cdh66666/mini-drone/docs/hardware/硬件说明.md

# 硬件资料说明（原理图 / PCB / KiCad 工程）

板号：**ESP32-1S-Basic-R4-E07**　　整理日期：2026-11-09

这个目录放的是**电路侧**的资料，和上级目录的固件、调试页配套。
看引脚接线直接看第二节的对照表，不用去翻 PDF。

---

## 一、三个文件分别是什么

| 文件 | 内容 | 大小 | 怎么用 |
| --- | --- | --- | --- |
| `01_原理图_SCH_ESP32-1S-Basic-R4-E07_2026-11-08.pdf` | 完整原理图，1 页全展开 | 219 KB | 看网络连接、查器件位号、对照飞线 |
| `02_PCB图_PCB_ESP32-1S-Basic-R4-E07_2026-11-08.pdf` | PCB 各层视图，6 页 | 1.66 MB | 看叠层/走线/丝印/焊盘位置 |
| `03_KiCad工程与制造文件_20261109.zip` | KiCad 工程 + Gerber + 钻孔 + BOM + 贴装坐标 + DRC/ERC 报告，177 个文件 | 12.2 MB | 要改板才解压，见下面「怎么打开」 |

### 怎么打开 KiCad 工程

1. 整个 zip **完整解压**（不要只挑 `.kicad_pcb` 出来，它会找不到符号/封装/3D 模型）；
2. 打开 `01_历史工程_v5_非实板确认版/KiCad/ESP32-1S-Basic-R4-E07-Layout.kicad_pro`；
3. 需要 **KiCad 10.0.7 或更新的版本**（用 9.x 打开会提示工程版本过新）。

包里同时附了原整理方写的 `00_先读_版本与缺失.txt`、`README-先读-审阅范围.txt` 和
`SHA256SUMS.txt`，**建议先看那两个 txt**。

### ⚠️ 版本警告（重要）

包里的可编辑工程是 **2026-10-31 的 E08 v5 历史审阅版**，**不是**你手上这块板的最终版：

- 之后在嘉立创 EDA 里还做过板框圆角、原理图警告整理、MEC 关联修正，这些**没有**包含在里面；
- 里面的 Gerber 是**历史审阅文件，不要拿它再下一次单**；
- 贴装坐标只对那个历史版本有效，**不要直接套到实板**。

**判断依据永远是：实际制板订单的文件 + 实板丝印 + 实测。**
本目录的 PDF 是 11-08 从嘉立创导出的当前版视图，看接线以 PDF 为准，改板以云端工程为准。

---

## 二、引脚对照表（原理图网标 ↔ 固件）

从 `02_接口焊盘网络_历史v5.csv` 和 WROOM-1 符号表交叉核对出来的，
**和 `01_firmware/flight_v1` 里的引脚定义逐条一致**（这是本次核对的重点）。

| 功能 | 原理图网标 | U1 焊盘 | ESP32 GPIO | 固件里的名字 |
| --- | --- | --- | --- | --- |
| 电机 M1（前左） | `PWM1` → `M1_GATE` | 4（IO4） | **4** | `PIN_M1` |
| 电机 M2（前右） | `PWM2` → `M2_GATE` | 5（IO5） | **5** | `PIN_M2` |
| 电机 M3（后左） | `PWM3` → `M3_GATE` | 6（IO6） | **6** | `PIN_M3` |
| 电机 M4（后右） | `PWM4` → `M4_GATE` | 7（IO7） | **7** | `PIN_M4` |
| IMU SDA | `IMU_SDA` | 18（IO10） | **10** | `PIN_SDA` |
| IMU SCL | `IMU_SCL` | 19（IO11） | **11** | `PIN_SCL` |
| IMU 中断 | `IMU_INT` | 20（IO12） | 12 | **未使用**（轮询读取） |
| 电池电压采样 | `VBAT_ADC` | 38（IO2） | **2** | `PIN_VBAT` |
| USB 插入检测 | `USB_PGOOD_N` | 17（IO9） | **9** | `PIN_PGOOD`（低有效） |
| 原生 USB D− / D+ | `USB_DM_MCU` / `USB_DP_MCU` | 13 / 14（IO19/IO20） | — | 硬件 USB CDC，不用配 |
| 串口 0 | `UART_RX` / `UART_TX` | 36 / 37（IO44/IO43） | — | 引到 TP3/TP4，固件不用 |
| 复位 / 下载 | `EN` / `BOOT` | 3 / 27（IO0） | — | 引到 TP1/TP2 |

### 测试点（USB 焊盘坏了也能救）

| 测试点 | 网络 | 用途 |
| --- | --- | --- |
| TP1 | `EN` | 拉低 = 复位 |
| TP2 | `BOOT` | 上电时拉低 = 进下载模式 |
| TP3 | `UART_TX` | 备用串口（接 USB-TTL） |
| TP4 | `UART_RX` | 备用串口 |
| TP5 | `3V3` | 量 3.3 V |
| TP6 | `GND` | 地 |

> 板子方位：**USB 口那一侧是机尾**，M1/M2 在机头。M1 ↔ M4 对角、M2 ↔ M3 对角。

---

## 三、关键器件（BOM 核对过）

| 位号 | 型号 | 作用 | 备注 |
| --- | --- | --- | --- |
| U1 | **ESP32-S3-WROOM-1-N8R2** | 主控 | 8 MB Flash + 2 MB PSRAM，实测吻合 |
| U2 | **TPS63020DSJR** | 升降压 DC-DC → 3V3 | 1S 电池 3.0–4.2 V 全程稳 3.3 V |
| U3 | **QMI8658A** | 六轴 IMU | I2C `0x6B`，LGA-14 |
| U4 | **BQ24073RGTR** | 线性充电管理 | USB 插入充电 + 系统供电，实测 189 mA |
| Q1–Q4 | **CJ3400**（SOT-23 NMOS） | 四路电机低边开关 | 栅极 330R 串阻 + 100k 下拉 |
| D1–D4 | **SS34**（SMA 肖特基） | 电机续流 | 关断时给电机电流留回路 |
| L1 | 1.5 µH（MWSA0518S-1R5MT） | TPS63020 电感 | |
| J1 | KH-TYPE-C-16P | USB-C 口 | 16 pin，含 CC 电阻 5.1k |
| J2 | 电池焊盘 | 1S 电池输入 | |
| JM1–JM4 | 电机焊盘 | 四路电机输出 | 每路 2 pin：VBAT + 漏极 |

**驱动器拓扑（决定了固件的限制）**：

```
VBAT ── 电机 ── JMx ── Qx(CJ3400, 低边 NMOS) ── GND
```

低边斩波、**只能单向导通**：固件没法反转转向，换向只能对调电机两根线
（详见上级 `README.md` 第 3.4 节）。四轴本来就只需要一个方向，靠正反桨抵消反扭。

---

## 四、和固件/文档的对应关系

| 想查什么 | 看哪里 |
| --- | --- |
| 引脚 → 固件变量 | 本文件第二节 |
| 实测电压/充电电流/IMU/射频 | `../04_docs/测试报告_2026-11-08.md` |
| 编译参数（FQBN 四项） | `../README.md` 第四节 |
| 烧录地址 | `../03_bin/flash_args.txt` 和 `烧录说明.txt` |
| 板子丝印与焊盘位置 | `02_PCB图_...pdf` |
| 改板 / 重新下单 | `03_KiCad工程与制造文件_20261109.zip` —— **但那不是最终版，务必从嘉立创云端工程重新导出** |

---

## 五、文件校验（SHA256）

用于确认传输过程没损坏，不是安全验证：

```
b21479bebe028deceafcf9701811e0e159e546ab097fe9e5d8eeb88f3b7027f9  01_原理图_SCH_ESP32-1S-Basic-R4-E07_2026-11-08.pdf
92ef4f147be5dbc3df9b1bb112a23c6b671f24f32eea6c8d500278ec2a9ee25d  02_PCB图_PCB_ESP32-1S-Basic-R4-E07_2026-11-08.pdf
06b610a558527d2b6ef2a2d76e942dcb7ad5a38f47f2bf19ceb2d27232eb7394  03_KiCad工程与制造文件_20261109.zip
```

Windows 上核对：

```powershell
Get-FileHash 01_*.pdf -Algorithm SHA256
```

---

## 六、这份硬件资料不包含什么

- ❌ 不含已验证适配实板的**电机固定架**（3D 打印件）——保持力、振动、打印公差都没验过；
- ❌ 不含最终版嘉立创云端工程（`.epro2`）的原生导出；
- ❌ 不含任何电气/热/振动的第三方复检报告；
- ❌ 不含 PCB 叠层铜厚与阻抗的实测数据。

这些缺口不影响按本包调参飞行，但**别拿它当"可以做认证/量产"的依据**。
