cdh66666/mini-drone/交接.md

# mini 无人机

- 项目对话由“总控”开，标题“mini无人机”。和“三门项目课”里的陆空两栖清洗无人机是两回事，别混。
- 用户是小白、急着想飞；界面极简、按钮/图标优先；网页只在本地，不发布。

## 11-09 调试台

- 资料包原件：`C:\Users\admin\WorkBuddy\2026-11-08-23-03-04\ESP32-1S无人机_代码资料包_2026-11-09.zip`
  解压在 `D:\cc_work\mini-drone\pack\ESP32-1S_drone_pack\`（README 最全：引脚、串口命令、参数、安全机制）。
- 板子：ESP32-S3 自制 1S 四轴，USB 串口 **COM11**（VID 0x303A）。现在跑的就是 `flight-v1`（`V` 回 `#VER,flight-v1,7C:0C:5F:8E:B7:DC`），**没刷固件**，所以没做备份。
- **调试台：`D:\cc_work\mini-drone\fly.html`**，用 Edge/Chrome 直接打开（Web Serial）。五步：连接 → 放平校准 → 电机（先拆桨才解开按钮）→ 起飞（4 项勾选才能解锁，油门往上限速 50%/s，方向键扶正，降落按钮）→ 手感两个滑块（稳↔灵、抖↔晃）。空格 / 右上角急停；页面失焦也急停。
  - `fly.html?mock` = 模拟飞机，没接板子时看界面用；本地预览服务在 `.claude/launch.json` 的 “fly”（127.0.0.1:8770）。
- 固件坑：串口长行（`#S,{json}`、`#PARAMS`）发不出来，只有短行能收到。所以页面用 `D,` 帧（电压/输出/解锁/故障）+ 每 200 ms 发 `P` 读 `#DBG` 的 roll/pitch。读不到板子当前存的参数。
- 参数（11-09 总控要求改）：页面连上先发 `C` 读原参数，读到 → 存 localStorage + 下载 `飞机原参数_*.json`，再写默认值并 `W`；读不到 → 默认值只用 `E` 改内存，**绝不 `W`**（校准、调滑块也不存）。“↩ 原参数”按钮：有备份按备份写回，没有就发 `U`/提示重新上电。
- 现状：这块板的 `C`/`U` 都没回应（`U` 实测不生效），所以页面走“只改内存”，飞机存储里的原参数一直没动过，重新上电就回到原值。原值读不出精确数，用自检 `Z` 的 closed_loop 指纹（ang=12.3, rate=4.0）推算约 angP≈2、rp≈1、ri 0.15；我测试时用 `E` 临时改过 angP/rp，已改回，指纹核对一致。页面从没连上过飞机（rp 仍为 1）。
- 副作用：重新上电后校准的水平补偿会丢，每次上电要在第 2 步重新校准。
- **11-09 晚：本地服务 `mini-drone/drone_server.py`**（`.claude/launch.json` 的 “drone”，127.0.0.1:8771，打开就是 fly.html）。侧栏浏览器没有 Web Serial，所以页面走这个服务；点“连接飞机”自动找：先 WiFi（192.168.4.1）再 USB。
  - WiFi：电脑 WiFi 连飞机热点 DroneBench（这台电脑只有 WiFi 上网，连上后电脑断网，Claude 也暂时用不了，飞完切回 SCF-Corp）。服务把命令翻成 /api/*；WiFi 下 /api/params 能读到原参数 → 自动备份并允许存盘。
  - 测试：USB 真机在侧栏里连上、读到电压/姿态；WiFi 用资料包 `_mock.py`（launch “drone-mockhttp”+“drone-wifimock”）走通备份、校准、点电机、解锁、油门、急停。
  - 以后想不断网：改固件让飞机连电脑热点/路由器（STA 模式），要刷固件，还没做。
- yp=0：不做偏航控制，悬停时会慢慢自转，正常。
- 无线飞：手机连 WiFi `DroneBench`，开 `192.168.4.1`（固件自带页面）。
- Claude 自己没转过电机（不确定桨拆没拆）。带桨起飞只由用户操作。

## 11-09 夜：固件 v2（无线调试 + 无线刷固件）

- 用户不想改电脑 WiFi（改了就断网），要无线调试、无线烧录。
- **固件 `flight-v2`**：源码 `mini-drone/firmware/flight_v2/flight_v2.ino`，由 `tools/make_v2.py` 从资料包 flight_v1 生成（改 v2 时改脚本再生成）；编译产物 `firmware/build/flight_v2.ino.bin`。新增：AP+STA（DroneBench 热点保留兜底）+ 连保存的 WiFi（串口 `N,<hex ssid>,<hex pass>` / `N?` / `NS` 扫描 / `NX` 忘记）、mDNS `minidrone`、API 加 CORS、串口 TX 缓冲 2048 + 不阻塞（修好了长行收不到；也修了“USB 插着没人读时主循环卡死、WiFi 断”）。
- **刷前整片备份**：`mini-drone/backup/flash_before_v2_20261109.bin`（8MB，esptool --no-stub 读；stub 模式会中途报错）。原参数从备份 NVS 解出：`backup/原参数_从备份解出_20261109.json`（angP 2、rp/pp 1、ri/pi 0.15、rd/pd 0.06、yp 0、idle 0、mthr 700）。页面 localStorage 的“↩ 原参数”也是这组。现在飞机里存的是默认值（angP 6、rp/pp 3）。
- 飞机已连 **SCF-WiFi**（开放网络，电脑在 SCF-Corp 能直接访问），IP **192.168.20.12**（记在 `mini-drone/drone_ip.txt`）。SCF-Corp 只有 5G，飞机连不上；飞机扫到的 2.4G：SCF-WiFi、SCF-IoT-2G 等。
- 无线刷固件已实测：页面“⬆ 更新固件”→ 服务把 `firmware/build` 里最新 .bin POST 到 `/api/update`（USB 模式则用 esptool 写 0x10000）。改固件流程：改 make_v2.py → 生成 → arduino-cli 编译（FQBN 见资料包 README）→ 点更新 / curl。
- 页面不再弹下载保存框，备份只存 localStorage。用户用侧栏（launch “drone”，127.0.0.1:8771）；备用：双击 `mini-drone/启动调试台.bat`。
- Claude 仍没转过电机。

## 11-09 深夜：固件 v3（UDP 控制）+ 电机测试

- 用户把飞机绑在桌上带桨测试，外接“2K Camera”对着飞机（OpenCV MSMF 索引 0；Windows 相机应用开着会占用，要先关）。用户让 Claude 帮测电机，Claude 用点动（300‰、1.5 s）测过；绑着、带桨。
- 电机：四个都能转（`test/spin_grid.jpg`，M1 在画面最远处、M4 最近）；150‰ 都转不起来。麦克风（摄像头自带）测叶片频率：M2、M4 稳定约 620 Hz（300‰），M1、M3 离麦太远测不准。结论：不用单独校准，PID 的积分会补；**绑在桌上解锁推油门时，各电机转速本来就会越差越大（姿态环想纠正却动不了）**，不是坏了。脚本 `tools/motor_audio_test.py`、`tools/motor_cam_test.py`。
- 掉线：原来控制心跳走 HTTP，飞机网页服务偶尔卡住几百毫秒到几秒 → 0.9 s 超时上锁。**v3**：UDP 4210 独立任务（core 0）收 `U,seq,live,thr,r,p,y`、回 `T,...` 遥测；`X` 急停也走 UDP。电脑端 25 Hz 发；页面 0.4 s 没发油门就停喂心跳（安全）。每秒丢包/延迟/最长空档写 `mini-drone/drone_link.log`，页面右上角显示“📶 信号差”。实测解锁保持 20 s 没断，最长空档 375 ms。
- v3 由 `tools/make_v2.py` 生成到 `firmware/flight_v3/`，产物 `firmware/build/flight_v3.ino.bin`，已无线刷入（页面/服务 `/api/flash` 取 build 里最新的 .bin）。v2 版服务备份 `backup/drone_server_v2_before_udp.py`。
- 充电时（USB 插着）可以测，v2 起已修“USB 插着没人读会卡死”。

## 11-09 23:15：起飞侧翻 → 固件 v4 + 黑匣子 + 方向检查

- 用户：油门 50% 左右离地不到 5 cm 就侧翻，每次都这样。链路日志当时没掉线。
- **v4**（`firmware/flight_v4/`，已无线刷入）：输出油门 < iThr（默认 250‰）时不积分并清零（地上攒积分 → 离地猛歪）；IMAX 350→150；黑匣子：解锁期间 250 Hz 记最后 4.8 s，`GET /api/bb` 出 CSV（含 thr/roll/pitch/gyro/sp/oR/oP/o1-4/itR/itP/杆位）；串口 E 支持 sgR/sgP/sgY/trim/mang/trMax/iThr。
- 服务：飞机上锁时自动取黑匣子存 `mini-drone/flights/<时间>.csv`，页面提示“📦 这次飞行已记录”。`tune.json` = Claude 调好的基准参数，页面连上时按它（再乘滑块）写入飞机；**调参改 tune.json**。
- 页面第 2 步加“🖐 方向检查”：抬机头 → pitch 应正，抬左边 → roll 应正；反了自动改 sgP/sgR 并保存；轴转 90° 会提示。
- 还没拿到飞行记录（飞机当时倒扣在镜头外，没法解锁测黑匣子；黑匣子接口已确认能返回）。下一步：用户做方向检查 + 飞几次 → 读 flights/*.csv 调参。
- 怀疑顺序：IMU 方向符号 > 桨装错（M1/M4 一种、M2/M3 一种）> 地面积分（v4 已修）> 增益。

## 11-10：读 6 次黑匣子 → 调参

- 记录在 `mini-drone/flights/20261109_2319xx–232100.csv`。第 5 次：离地后两轴都在 ±40° 来回摆，角速度顶到陀螺量程 ±512 dps，oR/oP 在 ±900 之间来回跳 = 增益太大的极限环。第 6 次：低空抖着慢慢歪到翻。
- **方向是对的**：纠正量和随后角速度变化正相关（R +0.5~0.8、P +0.4~0.8）。注意：这块固件的混控“pitch+ 时 3、4 号加力”，所以抬 1、2 号那边时 pitch 读数应为**负**；页面方向检查原来写反了，已改（没被用过，sgP 仍为 1）。前后杆方向以后要实测再定。
- 模型拟合（`tools/tune_sim.py`）：角加速度 ≈ 11~12 dps/s 每 ‰，电机滞后 τ≈50 ms，纯延迟 ≈25~30 ms。原参数 rp 3 / angP 6 在仿真里发散；**新参数 angP 4、rp/pp 1.0、ri/pi 0.5、rd/pd 0.05**，54 组极端模型全稳。已写入 tune.json、飞机并保存，页面滑块归零。
- 等用户再飞几次，读新的 flights/*.csv 再微调。

## 11-10 02:10：第二轮调参

- 新记录 `flights/20261110_020752.csv`（rp 1/angP 4）：油门约 357‰ 刚离地时横滚出现约 10 Hz 振荡，越来越大，随后三轴 ±500 dps 翻滚（用户说的“像陀螺四角轮流着地”）。
- 判断：上一轮模型是用贴地数据拟合的，低估了空中灵敏度（按 38 g、臂长估 b≈50 dps/s/‰，拟合只有 12）。rp 1 在 b≈50 时正好在 ~10 Hz 失稳，和记录吻合。
- 新参数（b 10~100、τ 15~80 ms、延迟 8~40 ms 共 48 组全稳）：**angP 3、rp/pp 0.25、ri/pi 0.2、rd/pd 0.008**，已写入飞机并保存、tune.json、页面重载。
- 若仍振荡：再减半 rp/rd；若软趴趴扶不正：rp 往 0.35 加。yaw 仍不控（yp 0）。

## 11-10 02:15：第三次（rp 0.25）→ 找到 pitch 符号反了

- 记录 `flights/20261110_021302.csv`：10 Hz 振荡没了，离地约 378‰。横滚一直 ±2° 内（roll 方向对）。pitch 300 ms 内从 5° 单调长到 50°：oP 越来越负（1、2 号加力、3、4 号减力），gp 却越来越大 = **pitch 正反馈**。之前“方向是对的”的相关性分析是被振荡骗了，作废。
- 修：`sgP=-1`（陀螺和角度一起翻），trimP 跟着变号 0.32，已保存进飞机。现在 pitch+ = 1、2 号那边往下 = 往前飞；页面方向键上/下已对调；页面方向检查“抬 1、2 号那边 pitch 应为负”与此一致。
- 参数仍是 angP 3、rp/pp 0.25、ri/pi 0.2、rd/pd 0.008。下次飞起来若稳但软，rp/pp 往 0.35 加。

## 11-10 02:20：第四次（sgP=-1）

- 记录 `flights/20261110_021541.csv`：离地后 pitch、roll 都慢慢长（0.3 s 到 12°），控制量 oP/oR 很小（-20~-30‰）→ 增益降过头了，扛不住扰动；之后翻滚。
- **教训**：闭环里“控制量 vs 角速度变化”的回归/相关性分不清因果（发散时 oR=-k·gr 必然负相关），不能用来判方向。方向只能开环测：页面“方向检查”（用户手抬：抬 1、2 号那边 pitch 应为负；抬 1、3 号那边 roll 应为正），每次点都会重新读当前符号。
- 电机位置已由摄像头确认（M1 远、M2 右、M3 左、M4 近，顺时针 1-2-4-3），和混控命名一致。KiCad 工程是旧版，不能用来判 IMU 方向。
- 参数改为 angP 4、rp/pp 0.35、ri/pi 0.5、rd/pd 0.01（存进飞机 + tune.json）。等用户做方向检查后再试飞。

## 11-10 02:30：方向检查报“转了 90°” → 固件 v5（IMU 安装角）

- 用户做方向检查，页面提示“传感器方向转了 90°”：抬一条边时主要变化在另一个轴 = IMU 相对电机布局转了约 90°（或 45°）。这就是一直翻的根因（roll/pitch 串轴，调增益无用）。截图没传上来、原始读数当时没存。
- **v5**（`firmware/flight_v5/`，已无线刷入）：参数 `rot`（度，存 NVS），陀螺和加计的 x/y 先绕 z 转 rot 再进姿态/控制；`E,rot,<deg>` 串口和 HTTP 都能改；/api/params 输出 rot。
- 页面方向检查重写：用原始加速度（D 帧 ax/ay）测两次抬边的倾斜方向，算出任意安装角 rot 和 sgP（sgR 固定 1），清 trim，保存；原始数据写 `mini-drone/notes.log`（/api/note）。约定：抬 1、2 号边 pitch 负；抬 1、3 号边 roll 正。
- 等用户再做一次方向检查 → 校准水平 → 试飞。

## 11-10 02:40：能飞了 → 固件 v6（防自转）+ Enter 一键起飞

- 方向检查结果（notes.log）：rot = -89°，sgR 1、sgP 1，已存进飞机。之后 4 次飞行姿态稳在 ±2~4°（sd ≈1°）。用户：“已经能飞了，但很不稳、到处跑；慢慢推不行，要一下子到 50 多”。
- 记录 `flights/20261110_022938.csv`：姿态稳，但偏航角速度从 -18 一路涨到 -204 dps（yp=0 没有偏航控制 → 反扭矩差越转越快）→ 转快后姿态估计乱 → 乱跑、翻（023047、023109）。
- **v6**（已无线刷入）：偏航积分 yi（RAM），地面（thr<iThr）清零；`/api/yawtest?pm&ms`：未解锁时依次点动 M1、M2，积分机身偏航角速度，返回 {m1,m2,sgY}。约定：M1 加速时应为正、M2 为负（与混控 oY 一致），反了翻 sgY。
- 页面：第 3 步“🌀 防自转检查”（桨装着放桌上）→ 通过后 localStorage `fly.yawOK`，之后连上才写 yp 0.8、yi 0.5（没通过一律 yp=yi=0）。第 4 步 Enter = 一键起飞到设定值（默认 60%，油门条下方小框可改，存 localStorage）；未解锁时 Enter 会先解锁再跳。
- 起飞时慢推不行是地面效应 + 腿着地时姿态环在顶，一下子过去才对。
- 还会乱跑：没有位置传感器（没光流/气压计），只能靠水平校准 + 方向键修；trimP 4.05 偏大，可能校准时桌面不平。
- 11-10 02:45：用户发现每次方向检查结果不同（-89、-103…，手抬有 ±10° 误差）。rot 定为 **-90** 已保存；页面以后离 90° 整数倍 <25° 自动取整。改 rot 后要重新“校准水平”（trim 是旧 rot 下标的）。

## 11-10 02:57：固件 v7 + 页面免点击

- 记录（024927、025030）：悬停 ~4 s 姿态 ±3°；用户按方向键（杆 0.35 → 倾 8.7°）就冲出去撞；偏航仍越转越快（-25→-100 dps）。上次防自转检查失败：M1 几乎不扭（0.04°），M2 扭 +1~2°（M1 可能偏弱）。
- **v7**（已无线刷入）：/api/yawtest 测 4 个电机 m1..m4。页面判定 s = m1 - m2 - m3 + m4，>1 方向对、<-1 翻 sgY、否则不开防自转。
- 页面：Enter 任何一步都能起飞（先跳到起飞页、4 个勾自动打上并记住、自动解锁、跳到设定油门）；**第一次** Enter 先自动做防自转检查（fly.yawTried）；方向键杆量 0.35→0.14（≈3.5°）；校准后记 fly.ready，以后连上直接到起飞页。所有校准（trim、rot、sgY）都在飞机 NVS 里，断电不丢。
- 飞机现状：rot -90、sgR/sgP/sgY 1/1/-1、trimR -0.77、trimP 4.75、angP 4、rp/pp 0.35、ri/pi 0.5、rd/pd 0.01，yp 0（等防自转检查通过）。

## 11-10 晚：固件 v8（卡尔曼 + 偏航）+ 页面确认按钮

- 用户要求：不要只用加计或陀螺，用卡尔曼融合；偏航补偿；Enter 只在起飞页、四个勾合成一个确认按钮；偏航显示在调试台；空中偏航试探“为啥每次都要”。
- **v8**（`firmware/flight_v8/`，已无线刷入）：
  - roll/pitch 改两状态卡尔曼（角度+陀螺零偏，Qa 0.001、Qb 0.003）；R 地上 0.03、空中（解锁且输出>iThr）3.0、|a|偏离 1 g >0.15 时 30；新息和角度做 ±180 回绕。
  - 偏航补偿：未解锁、静止（三轴 <2 dps、|a|≈1 g）时陀螺零偏慢慢更新（α 0.002）；解锁时偏航角清零。
  - 电压补油门：thr × 3.95 V / vbat（限 0.92~1.2），`E,vcomp,0` 可关。
  - 空中偏航试探（只在 yp=0 时做，**只做一次**）：离地 1.5 s 后 oY +60‰ 0.25 s、-60‰ 0.25 s，d =（+段 gy 变化）−（−段 gy 变化），|d|>8 就定 sgY（d<0 翻）、开 yp 0.8 / yi 0.5，落地后 paramsSave（串口 #ACK,YAWSET）。之后 yp>0 不再试探。`E,yprobe,0` 可关。
  - 黑匣子加 oY、az、yaw 三列；表头带 yp/sgY/probeD；UDP 遥测末尾加 yaw。
- 页面：一个“✅ 确认”按钮（每次打开页面点一次）；Enter 只在起飞页且确认后有效；不再写 yp/yi（偏航交给飞控）；地面防自转按钮隐藏；起飞页加偏航指针 + 自转°/s（>60 变红）。
- 03:23~03:24 的 8 次（v7）：每次在空中只有 ~2 s，thr 490，估计姿态 ±1~2°，偏航随机方向转到 ±90 dps。
- 诚实说明：没有气压计/光流/测距，定点定高做不到，只能减漂（卡尔曼、配平、电压补偿）。

## 11-10 夜：历史回放 + 模型对比 + 位置推算

- **回放页** `mini-drone/replay.html`（服务 8771 上 `/replay.html`；每次打开 `/flights/replay.json` 都会重跑 `tools/replay_build.py`）：左边选飞行，中间 3D 小飞机按记录的姿态/偏航/电机输出重放 + 绿线推算轨迹，右边实测 vs 模型角速度、四个电机曲线；空格播放、½ 慢放、拖动视角/滚轮缩放。
- 模型（rot 修好后的 24 次空中数据拟合，陀螺 10 Hz 平滑）：横滚 b≈14、俯仰 b≈23 °/s²/‰，延迟 ~32 ms；但吻合度多为负 → **用悬停闭环数据辨识不出滚转/俯仰模型**（控制量跟着角速度走，分不清因果）；偏航吻合 0.5~0.9 只是因为自转近似匀加速。要可靠模型得像偏航试探那样做主动激励。
- 位置：倾角→水平加速度（加阻力 1.2/s）二次积分 + az/油门估高度。多数修好后的飞行 2~5 s 推算位移 0.1~0.5 m，几次 4~8 m（大角度/翻倒时）。1° 姿态偏差 3 s 就漂 ~0.8 m，所以只能看趋势。
- 用户：回放和看到的一致，基本都是起飞后往后移动（推算：修好后 28 次中 27 次往后，x 均值 -0.49 m）。印象深的两次：**最高 02:50:10**（油门到 100%，推算 1.6 m，低电压上锁）、**最转 02:31:09**（自转中位 194°/s，推算升到 3.5 m）；另一次转得多的是 03:12:22。回放列表里标了“🔝 最高”“🌀 最转”，`replay.html#<文件名前缀>` 可直接打开。
- 起飞页加了**实时推算轨迹**（俯视小图 + 高度条，解锁时清零，同一套算法）和“▶ 历史回放”按钮；回放页加“←”回调试台、俯视轨迹图。
- 待做：往后飘 → trimP 往前加 1°（4.75→5.75）。当时飞机没开机，**没改成**，下次连上先做。
- 用户计划：明天拍视频，Claude 拿视频和推算对比；用户想要能控轨迹、原地定点、定高。方向：用固定摄像头（2K 摄像头）当外部定位，电脑算位置 → UDP 发修正杆量/油门（视觉定点）。需要：机架顶贴亮色标记、摄像头固定能拍到整个飞行区、侧面能看高度。

## 11-10 20:40：固件 v9 + 连上自动执行

- 用户：不买传感器，先调软件；要“尽量稳、允许慢漂”。
- **v9**（`firmware/flight_v9/`，编好未刷）：角度外环积分 angI 1.5（只在空中积，地上清零，限 ±30°/s），消掉长期 ~-1° 静差；偏航试探 ±90‰、各 0.3 s（没测准下次起飞自动再测）。`E,angI,<v>` 可改。
- 服务：`mini-drone/pending.json` = 连上（WiFi）后自动做的事：`flash` 先无线刷 build 里最新固件（推 #NOTE 提示 + #LINK,lost 让页面重连），再 `trimP_add` 在当前 trimP 上加（现设 +1.0），做完从文件里删掉、写 notes.log。页面收到 `#NOTE,` 就弹提示。
- 现在 pending = {flash: true, trimP_add: 1.0}；飞机关机中。
- 20:40：页面改成**自动连接**（打开就连，没连上每 3 s 静默重试，断线自动重连）。飞机开机后自动连上，pending 已执行：v9 无线刷入、trimP 4.75 → 5.75。飞机 IP 变成 **192.168.20.7**（DHCP，drone_ip.txt 已更新，服务自动找得到）。当时电池 3.55 V，偏低。

## 11-11：界面整理 + 电量/充电/信号 + 配平上页面

- 用户：起飞界面乱、加载慢；电量要百分比+电压+预计充满；WiFi 要有信号质量；手感没用过、配平没出现过；要通用——换一台同样的飞机也能快速调好，不要没用的东西。
- 充电实测（`mini-drone/charge_log.csv`，tools/charge_log.py）：3.699→3.716 V / 246 s ≈ 4.3 mV/min，推到 4.15 V 再加恒压收尾 ≈ **1.5~2 小时**（资料包实测充电电流 ~189 mA，反推电池约 300~400 mAh）。
- 页面（旧版备份 backup/fly_before_redesign.html，补丁 tools/patch_redesign*.py）：
  - 顶栏：连接点 + WiFi 四格信号（RSSI 和丢包一起算，悬停看 dBm/丢包）+ 电池图标/百分比/电压/“⚡ 约 N 分钟充满”（页面记最近 10 分钟充电电压线性外推到 4.15 V +10 分钟；充电时扣 0.1 V 再查 1S 锂电表；飞行中冻结百分比）。
  - 导航：连接 / 校准 / 电机 / 飞行；手感页隐藏。
  - 飞行页三栏：左油门（⏎ 一键值）；中三个仪表（姿态气泡、偏航指针+自转°/s、推算轨迹圆盘+高度条）+ 电机条 + 历史回放链接；右：安全确认、解锁、降落、**配平四键**（每点 0.5°，立即写入并保存；“总往哪飘就点反方向”）。
- 服务：连接时先试记住的地址 0.8 s，通了直接用（加载快）；用 mDNS 找到新地址也记下来。
- 新机流程：连接（USB→连 WiFi→更新固件）→ 校准（水平 + 方向检查自动算 rot）→ 电机（拆桨看转向）→ 飞行（首飞自动测偏航方向、开防自转；飘就点配平）。
- 充电电路（原理图 01_原理图 PDF）：U4 BQ24073，**R15 = 4.7 kΩ 接 ISET → 充电电流 890/4700 ≈ 189 mA**；EN1 接系统电源、EN2 接地 = USB500 模式（输入限 500 mA）；R20 4.7k 在 ILIM（此模式不起作用）。电池按测试报告约 500 mAh → 189 mA 充满约 2.5~3 h。**提速：R15 换 2.2 kΩ → ~400 mA（0.8C），约 1.5 h**；受 500 mA 输入上限和系统耗电（~100+ mA）限制，再小也快不了多少；线性充电发热 ~0.5 W，芯片有过温降流。用户还没决定换不换。
- 电量百分比：充电时端电压扣 0.06 V 再查表（原来扣 0.1 V）。3.72 V 充电中 ≈ 静置 3.66 V ≈ 8%；插电前静置是 3.55 V（≈2%）。
- 11-11：**整次飞行记录**（电脑端，解锁→上锁，25 Hz）存 `mini-drone/flights/full/<时间>.csv`：t、vb_mv、thr_cmd（杆量‰）、stick_r/stick_p（方向键）、roll、pitch、yaw、gy、o1-4、rssi。回放页列表里标“整次·电压”，新增“操作”图（油门%、左右/前后杆）和“电池 V”图（起飞→落地电压、空中秒数）；黑匣子那几次也显示油门和杆量。已用解锁 2 s（油门 0）测过能存，测试文件已删。
- 电量显示防抖：电压约 20 s 平滑，百分比充电时只升、放电时只降、飞行中冻结。

## 11-11 13:07：新电脑首飞（2 次，参数未改）

- 新电脑：Python 用 D:\Python311（PATH 里没有），已装 pyserial/numpy；`.claude/launch.json` 的 “drone”；启动调试台.bat 已改成优先用它。飞机 COM13，WiFi IP 仍 192.168.20.7。
- 记录 flights/20261111_130721、130737（+ full/）。一键油门 60%，空中 5.5 s / 3 s，用户手动降落，没翻。
- 姿态 sd 1~2°（最大 ±7°）；自转 ≤ ±36 °/s（以前 90~200），防自转生效；推算漂移 0.2 m / 5 s（第二次 0.45 m，有用方向键）。
- itP 约 +10、3/4 号比 1/2 号多约 20‰：重心偏 3/4 号侧，积分在补，不用管。
- 电压：静置 3.92 V → 起飞瞬间 3.58 V（掉约 0.35 V），5 s 后 3.53 V。低压保护 3.25 V。
- 结论：这组参数可以用，没改。下一步：飞久一点（10~20 s）看续航和漂移方向，再决定配平。
- 用户目标：不操作，起飞后 5 s 内停在 0.1 m 以内。只靠 IMU 做不到（要倾角误差 <0.05°）→ 用摄像头。
- **飞行录像**（`cam_rec.py`，服务启动就开摄像头，解锁前 1 s 到上锁后 1 s）：`flights/video/<名字>.mp4` + `_t.csv`（每帧相对解锁的秒数），名字和 full/ 一样。`/api/cam` 状态、`/api/cam.jpg` 当前画面。摄像头编号写 `camera.txt`（默认 0 = 笔记本 HD Webcam，DSHOW）。
- `tools/video_track.py [名字]`：背景差找飞机 → `_track.csv`（dx 左右、dy 上下，米，按飞机宽 0.10 m 定比例）+ `_check.jpg` 拼图。
- 11-11 下午：摄像头全黑是因为 Windows“相机”应用开着占用；关了就好（cam_rec 一直黑会每 5 s 重开）。约 10 fps。
- `video_track.py` 用法：`video_track.py <名字> [x,y 起飞点]`，起飞点记在 flights/video/start.txt；只认小块、挑真的在动的那条轨迹、离开起点后不回“空位”。
- **13:27 第一次带录像（132759）**：离地 0.3 s 内 pitch 往负歪到 -14°（oP 已 +50 也压不住），之后视频里飞机匀速 0.43 m/s 往画面左边（= 往后）走，1.5 s 出画面。前两次起飞也往负歪 4°。→ 漂移主要来自**起飞瞬间往后歪**给的初速度，之后没东西刹车。
- 原因：重心偏 3/4 号侧，悬停时 itP≈+6~10；但地上积分清零 → 一离地 3/4 号侧推力不够 → 往后歪。
- **固件 v10**（make_v2.py 末尾）：bR/bP（‰，NVS），地上把角速度积分放成 bR/bP（电机停时仍清零）。`E,bR/bP` 可改，/api/params 有。服务 `learn_bias`：每次上锁取黑匣子，平稳悬停 ≥0.8 s 时把 b 往空中积分中位数挪 60% 并保存，notes.log 记“bias”。按第一次飞行学到 bP≈6、bR≈-1.8。
- 0.1 m/5 s 的目标：要速度 <0.02 m/s，只靠 IMU 不行；修好起飞后若还漂，下一步用摄像头实时修正（UDP 发杆量）。
- 编译：arduino-cli 在 D:\codex\bionic-lizard\tools\arduino\arduino-cli.exe（借用）；esp32 core 3.3.2-cn 从国内镜像装（GitHub 下不动）：`--additional-urls https://jihulab.com/esp-mirror/espressif/arduino-esp32/-/raw/gh-pages/package_esp32_index_cn.json`。
- v10 已刷入，bP 6、bR -1.8 已存。
- **推算轨迹 vs 录像**（132759，黑匣子 250 Hz，不加阻力）：0.5/1.0/1.5 s 推算往后 0.01/0.21/0.46 m，录像 0.07/0.26/0.48 m → 推算短时间内可信，空气阻力很小。
- **固件 v11（已刷入）**：空中（thr≥iThr、没按方向键）用姿态积分机体系速度 vx/vy（g·tanθ − 0.3·v）和位移 px/py（限 ±1.5 m），角度目标加 −(vh·v + ph·p)，限 ±hmax。默认 vh 8 °/(m/s)、ph 3 °/m、vleak 0.3、hmax 8，`E,vh/ph/vleak/hmax` 可改（RAM，不存）。按方向键时清零。黑匣子多 vx,vy,px,py 四列。
- **11-11 17:07~17:09 v11 四次飞行**：起飞后 0.6 s 内 pitch 最大 -3.5°（以前 -14°），推算位移 ±0.23 m 内。最干净的一次 170939（空中约 8 s，没按键）：录像左右只在 -4~+14 cm 之间（18 cm 范围），落回起飞点附近；画面里一直在升高（一键 60% 比悬停油门大）。录像只能量左右，前后（朝/离镜头）量不准。重心补偿自学：bP 6→7.2→5.3，bR -1.8→-4.3。
- 调试台飞行页加了**摄像头实时画面**（`/api/cam.mjpg`，录像时显示“● 录像中”）。
- 追踪起飞点每次可能不同：`video_track.py <名字> x,y` 手动给；以后可以从解锁时那帧自动找。
- 仿真（`hold_sim.py` 思路：姿态一阶 τ 0.15、延迟 30 ms、起飞 -14° 0.2 s）：不开 1.9 m → 开 0.19 m/5 s；τ 0.3 或延迟 80 ms 仍稳。看不到的是水平校准本身的偏差（0.5° → 5 s 约 0.7 m）→ 用录像测慢漂、改 trim。
- **固件 v12（已刷入，11-11 17:20）阻力测速**：空中“加计倾角”（rollA/pitchA 减过 trim）≈ 阻力/g = μ·v/g，和水平校准偏差无关 → 不用摄像头也能看到慢漂。黑匣子新增 ap/ar（tan 加计倾角，低通前）、vdx/vdy（阻力测速）。参数 `E,mu`（默认 0.5，负 = 方向反）、`E,dk`（推算速度往阻力测速拉，1/s，**默认 0 = 关**，飞起来和 v11 一样）。
- `tools/fit_drag.py`：用黑匣子拟合 μ（g·ap = μ·(v_int + c0 + c1·t)），合成数据测过（真 0.6 → 拟合 0.54）。流程：不按键飞 2~3 次 → 跑脚本 → μ 稳定、R2 高就 `E,mu` + `E,dk,1`（再试 2）。
- 用户明确：**不要用摄像头**（控制、录像都不要，占内存）。11-11 起摄像头默认关；要开才建 camera.txt 写编号。
- **11-11 17:45 固件 v13（已刷入）平稳起飞 + 定高，只用自己的加计**：v11 的 9 次飞行里，竖直加计积分显示起飞 1 s 内冲到 10~15 cm、又掉回、再弹（竖直速度 ±0.25 m/s，周期约 1.5 s）= 贴地地效 + 固定油门。v13：地上把竖直加计读数当 1 g；空中积分 vz/hz；起飞后目标高度平滑升到 ht 0.4 m（爬升 0.3 m/s、快到时放慢），油门 = 悬停油门 hov（NVS，初值 405，电压补偿前）+ PID（khp 150、khv 250、khi 60，限 ±200）。**不用一键油门值**。油门指令变化 >3%（降落按钮/拖杆）就交回手动。落地后 hov += 0.6×积分平均并存盘（自学）。`E,ah,0` 关定高。黑匣子加 vz,hz,htg。
- 仿真（scratchpad alt_sim）：hov 准时超调 6 cm、之后 ±11 cm；hov 差 10% 时 ±18 cm，自学 3~4 次收敛；电机慢、加计偏 ±0.01 g 基本没影响。积分漏项（0.05）会让高度估计偏低 7 cm，已去掉。
- v12 阻力测速还没数据（v12 刷入后没飞过就升了 v13，v13 里照样记录 ap/ar/vdx/vdy，dk 仍 0）。
- **11-11 17:45 v13 三次实飞 → 定高不行**：竖直加计在空中受振动影响偏几 % g、随油门变（降落时油门降到 0，估计反而说在以 0.3 m/s 上升）；悬停时估计高度卡在 0.16 m，积分一直加油门。起飞那下油门冲到 550（以前 455），第 3 次起飞歪了 24°。→ 当场 `E,ah,0` 关掉。
- **固件 v14（17:52 已刷入）**：定高默认关（ah 0）；改成起飞油门 0.3 s 软启动（tramp）+ 只压上下弹：竖直速度高通（τ tz 0.6 s），油门加 −kdz·vz（kdz 200，限 ±dzmax 60‰）。高度仍由用户油门决定。黑匣子最后三列变成 vz（高通）、hz（积分，仅参考）、dz（压弹量/100）。
- 地效模型按实测拟合：60% 时浮在 10~15 cm、上下 ±0.25 m/s、周期 1.5 s（相当于 OGE 悬停油门比 60% 高 ~10%）。仿真压弹后摆幅 22 → 5~7 cm，振动偏差 ×3 也行。想飞高要自己加油门（出了地效没高度传感器，会慢慢漂）。
- v13 三次的阻力拟合 μ 很乱（前后 0.17/-1.44/-0.07），飞得太短还带降落 → 没结论，dk 仍 0。需要几次 5 s 以上不按键的悬停。
- **11-11 18:00 用户反馈：最近几次都飘得很厉害，估计 1 m**。而飞控自估位置 <0.1 m → 再次证实：v11 起控制器把自估位置拉回原点，自估轨迹天然好看，**不能当证据**。
- 回放页 / 飞行页已标清楚：绿线 = 自估（被拉回，不是真实位置），回放加了橙虚线 = 阻力读数积分（v12+，控制器没用，μ 未标定只看方向）。replay.json 每次飞行加 `pos_drag`、`selfhold`。
- 下一步想法（不用摄像头的真值）：起飞点贴胶带，飞 5 s 不碰键，量落地点相对起飞点的距离和方向（按机头方向）→ 用来标定阻力系数和水平偏差。
- **11-11 18:10 结论（物理上的限制，重要）**：匀速慢漂只靠机上 IMU **看不出来**。匀速时加速度为 0，加计在空中测到的和在地上一样，就是机身真实倾角（阻力正好被推力水平分量抵消）。所以“空中多信加计”和 v12 阻力测速都只能纠正**变化中的**漂（起飞冲一下、阵风、陀螺漂），纠正不了“飞机以为的水平”和“推力真正竖直”之间那个固定差（推力轴歪、重心、桌面不平时校的水平、加计偏差）。这个固定差 0.5~1° 就够 5 s 漂 1 m。我之前说“阻力能看到慢漂”是错的，已向用户更正。
- 能修这个固定差的只有：外部参照（摄像头/光流/卷尺量落地点，用户都不要）或**人看着往哪飘、点配平**（飞行页已有配平四键，每次 0.5°，按机头方向）。用户 11-11 要求换办法，不量、不用摄像头 → 只剩配平。
- **11-11 18:25 用户反馈三件事**：配平 0.5° 太大；方向键控制不了；起飞后只有 5~10 cm 高。
  - 数据：方向键（杆 0.14 = 3.5°）实际倾 2~4°，方向对但太小；**18:17~18:19 每次机头转 25~55°**（自转中位 ±10°/s），方向键按机头算 → 方向乱。60% 浮不出地效（拟合模型：63% ≈ 20 cm、64% ≈ 30 cm，再高就出地效、高度自己漂）。
  - 页面：配平每点 0.2°（18:50 用户要求再改成 0.1°）；方向键 0.24（≈6°）；一键起飞默认 64%（存储键改成 fly.tkoff2，旧的 60 作废）；W/S 每次 ±1%。
  - **固件 v15（已刷入）机头锁定**：空中没按偏航时 spY += −ya·(yawF − 起飞时 yawF)，限 ±60°/s，ya 默认 2（`E,ya`）。
  - 现在飞机里：trimR -1.16、trimP 3.78（用户点过配平），bR -7.1、bP 10.9（自学在变大，留意）。
- **11-11 18:42 v15 五次飞行**：机头锁定有效，机头只在 ±15° 内（以前 25~55°），oY 中位 -14~-20（一直要一点偏航力，电机不平衡）。方向键 0.24 → 实际倾 3~6°，方向对。油门 64% → 输出 ~530（以前 455）。姿态 sd 2~3°（多了按键）。o1 一直比其他低 30~40‰。
  - **电池快没电**：每次从 3.7 V 掉到 3.27~3.33 V（低压保护 3.25 V），几次都是油门还在悬停值时就结束 → 多半是低压保护断电。要先充电。
  - ya 2 → 3：写进 tune.json，页面 pushParams 连上自动发 `E,ya,3`（calcPid 带上 ya）。
- **11-11 21:30 电量显示修正**（用户说电量估得不准）：原来两处逻辑问题——①飞完马上取电压（还在回升）且“没充电只降不升”→ 卡在偏低的数；②插 USB 时固定扣 0.06 V 从头算，可能比插前还低。改：飞完不等（用户嫌 60 s、10 s 都慢），平滑 5 s；没充电时跟着平滑电压走（不再只降）；插上 15 s 后用实测电压跳变当充电偏移（先按 0.04 V），充电中只升、插上那一下不掉；充电且 ≥4.19 V 显示 100%。
- 服务每 10 s 记 `flights/battery_log.csv`（time, vb_mv, usb, armed, thr_cmd），攒一轮充放电后用来按这块电池校准电压-电量表、估容量（表现在是通用 1S 锂电表）。
