cdh66666/mini-drone/先看我.md

# mini无人机：换电脑接着做（给新电脑的 Claude 看）

用户在原电脑上做了一半，换到这台电脑接着推进。动手前先把这份说明读完，再读同一个文件夹里的另外三个文件：
- `交接.md`：项目的全部关键信息，包括板子、引脚、固件坑、参数、调试台怎么用、充电电路。最重要。
- `对话摘要.md`：原电脑上的对话，只留了说过的话，没有工具输出。最后几段就是最新进度。
- `用户习惯.md`：回复全用中文、要短；界面极简；计划你自己定；网页先在本地看。

## 这是什么
用户自制的 ESP32-S3 1S 四轴小飞机，配一个电脑上的网页调试台，有这几步：连接、校准、电机、飞行，另有回放。
注意：它和“陆空两栖清洗无人机”课程是两回事，不要混在一起。

## 停在哪（2026-11-11）
- 固件是 v9（`mini-drone/firmware/flight_v9/flight_v9.ino`），编译好的在 `firmware/build/flight_v9.ino.*.bin`。
- 调试台：顶栏能看电量%、电压、充满预计时间、WiFi 信号格；飞行页有配平四键。
- 整次飞行会自动记下来，存在 `flights/full/`；回放页有“操作”和“电池”两张图。
- 电量显示已经防抖；充电提示一插上线就会显示粗估时间。
- 最新状态：电量约 32%，正在充电，**等用户充到一半以上再试飞**。

## 放在哪
解压后把 `mini-drone` 文件夹放到 `D:\cc_work\mini-drone`，和交接里写的路径保持一致。代码里没有写死本机路径，放到别的地方也能跑。

## 新电脑要装的（都能联网下，所以没打包）
1. **Python 3.10 以上**。调试台的服务只用标准库。`tools/replay_build.py` 要 `numpy`；`motor_cam_test.py` 要 `opencv-python`，`motor_audio_test.py` 要 `sounddevice`，这两个是可选的。
2. **Edge 或 Chrome**。页面会用到 Web Serial。
3. **改固件才需要**：
   - `arduino-cli`，再装 esp32 core 3.3.x：`arduino-cli core install esp32:esp32`。
   - `pip install esptool`。
   - 编译参数 FQBN 必须写全：`esp32:esp32:esp32s3:CDCOnBoot=cdc,FlashSize=8M,PSRAM=enabled,PartitionScheme=min_spiffs,USBMode=hwcdc`。
   - 换了电脑，USB 串口号多半不是 COM11，到设备管理器里看（VID 0x303A）。

## 怎么启动
双击 `mini-drone/启动调试台.bat`。它会在 127.0.0.1:8771 开服务，并自动打开浏览器。
- 飞机连的 WiFi 地址记在 `drone_ip.txt`；换了路由器的话，服务会用 mDNS 重新找。
- 不接板子只想看界面：打开 `fly.html?mock`。

## 包里有什么
- 网页和服务：`fly.html`、`replay.html`、`drone_server.py`、`tools/`（生成固件的 `make_v2.py`、页面补丁、测试脚本）。
- 固件：v2 到 v9 的源码；编译好的 bin 只带了 v9（无线更新固件用的就是 `firmware/build` 里最新的那个）。
- `backup/flash_before_v2_20261109.bin`：**板子原厂固件整片备份，8 MB，千万别删**。同一个文件夹里还有原参数。
- `flights/`：用户的飞行记录。
- `pack/ESP32-1S无人机_代码资料包_2026-11-09.zip`：用户自己做的资料包：电路板、原理图、物料清单、引脚、串口命令、最早的固件。
- **没打包的**：
  - 旧版本的编译中间文件，大约 640 MB，用 arduino-cli 能重新编出来。
  - 旧版 KiCad 工程，交接里写了“不能用来判 IMU 方向”。
  - 测试截图和日志。

## 安全
没有用户明确要求，不要解锁，也不要转电机。试电机前要先拆桨。
