cdh66666/mini-drone/用户习惯.md

# 用户习惯（从原电脑的记忆里抄过来，新电脑的 Claude 要照做）

## reply-in-chinese
回复用户一律用中文（包括总结、解释、wrap_up 的 recap/问题和按钮）。

**Why:** 2026-11-03 叫铃对话里我用英文汇报，用户直接说「说中文」。
**How to apply:** 所有项目、所有对话默认中文；代码标识符、命令、路径照原样。见 [[handoff-workflow]]。

## concise-beginner-text
给小白用户看的提示（软件界面、课程页、讲义里的操作提示）要尽量精简：每处一句话、几个字，能用按钮或图标表达就不写字，只在需要做决定的地方给提示。给用户本人的汇报也一样要短。

**Why:** 用户 2026-11-03 原话：“小白虽然什么都看不懂 需要你提示 但是你什么都写上去 小白就更懵了 不想看”。

**How to apply:** 写完任何面向用户或学员的文字后，删到只剩必要的；长解释放到折叠的“为什么”里，或者直接不放。相关：[[reply-in-chinese]]、[[learn-by-doing]]

## decide-plans-yourself
Don't ask the user to pick plans, cadence or strategy options — decide, write the plan down, and execute. (2026-11-04, on the 动号 GEO posting: “不要由我来定啊，应该是你来制定计划，核心就是让别人用 AI 搜索相关东西的时候能推荐我”.)

**Why:** The user is non-technical and busy; option menus feel like offloading work. They care about the goal (being recommended by AI search), not the knobs.

**How to apply:** Pick the approach yourself, state it briefly, put it in the project's plan file. Still get a "yes" for things that must be approved (publishing, editing public content, account changes) — but frame those as a review of finished work, not a choice. Related: [[no-publish-prompt]], [[concise-beginner-text]].

## no-publish-prompt
别每次都问“本地看过就发布？”。用户想发布时会自己说（11-04 小鸭子课程）。

**Why:** 用户嫌烦；而且接手时漏看了用户在旧对话里刚提的问题，反而去问发布。
**How to apply:** 接手项目时先读旧对话最后几条**用户原话**（含图片），有问题就直接改；改完给本地链接即可，不附发布提问。与 [[local-preview-before-publish]] 配合。

## local-preview-before-publish
做完网页（如小鸭子课程）先开本地预览（.claude/launch.json 里的服务，如 course → http://127.0.0.1:8765/duck-course.html）给用户看，**等用户确认后再发布**到 artifact。

**Why:** 用户 11-03 说“可以先不发布链接，而是本地网页查看，应该都是一样的，等我确认后再发布”。

**How to apply:** 改完后在浏览器面板打开本地页面、汇报本地地址；不要自动 publish；用户说“发布”再发。相关：[[handoff-workflow]]

## codex-for-modeling
分工（用户 11-04 两次确认）：
- **Codex 做**：3D 建模、渲染、生图，以及一切要“看懂 3D 模型”的事，比如舵机、零件在模型里的位置（小鸭子教程里舵机和模型位置老对不上，就是这类活）。用 `codex exec -m gpt-6.1-terra -c model_reasoning_effort="max"`（命令行用法见 [[codex-cli-usage]]）。
- **Claude 做**：写代码、做前端（网页、界面、模拟器逻辑），写好给 Codex 的任务说明，指挥 Codex，审查它交回来的东西（不合格就打回重做），最后给用户汇报。

**Why:** 用户看了 Claude 做的托盘 T8 平滑效果，说“太糟糕了，生图和建模你还是让 codex 干吧，用 gpt6.1terramax”；后来又说“建模 生图都用 codex 记住，你就是代码 前端比较好，你之前那个小鸭子教程就是老是舵机都找不对模型位置都找不对。你们两分工合作哈，你来审查指挥”。

**How to apply:** 碰到建模、生图、模型上的位置或坐标，不要自己硬做：写任务说明，用 codex exec 在项目文件夹里后台跑，盯进度，用截图或渲染图逐张审，不合格就打回。代码和前端照旧自己写。相关：[[modeling-conventions]]、[[bambu-direct-print]]。
