cdh66666/mini-drone/backup/fly_before_redesign.html

🚁 未连接 🔋 -- ⏹ 急停空格

🔌

连接飞机

🔌 插 USB 就行；飞机连过 WiFi 后不用插线

📶 飞机连 WiFi--

🔍 找 WiFi

连上

只能连 2.4G。列表里没有你的 WiFi → 电脑开“移动热点”（2.4GHz）再找

⬆ 固件

更新固件

## 放平 → 校准

▲ 机头

📐 校准水平 🖐 方向检查 下一步 →

放在平桌上别碰它，点校准。抬机头 → 气泡往 ▲ 跑。

⚠️先把 4 个桨全拆掉！

1 2 3 4

✂️ 桨已拆

① 点 1 → 2 → 3 → 4，每个转 1.5 秒

② 看实物转向跟图上箭头一样吗？

反了 → 对调这个电机的两根线（软件改不了）

四个一起 1.5 秒 都对 →

🌀 防自转检查

桨装着、放桌上、手离开 → 点一下（1、2 号各轻转 0.7 秒，不会飞）

油门

0%

W / S

⏎ 一键
%

✅ 确认：桨装好 · 空旷 · 人离开 · 线放松

推算轨迹（粗估）

▶ 历史回放

偏航 --

▲ 机头

1

2

3

4

① 解锁 → ② 慢慢推油门 → ③ 刚离地就停住 → ④ 方向键扶正
歪了、乱飞、害怕 → 按 空格

🔓 解锁 ⬇ 慢慢降落

↑ ←↓→

方向

📶 不拖线：拔 USB，电脑 WiFi 连 “DroneBench”，重新点连接

## 飞得不舒服？拖一下，自动保存

🐢 稳灵 🐇

〰️ 抖晃 🌊

🫨 反应太猛、一碰就窜 → 往 🐢

🐌 软趴趴、扶不正 → 往 🐇

〰️ 嗡嗡高频抖 → 往 〰️

🌊 来回晃、停不下来 → 往 🌊

↺ 恢复默认 ↩ 原参数
