cdh66666/mini-drone/flights/latest_175441.png

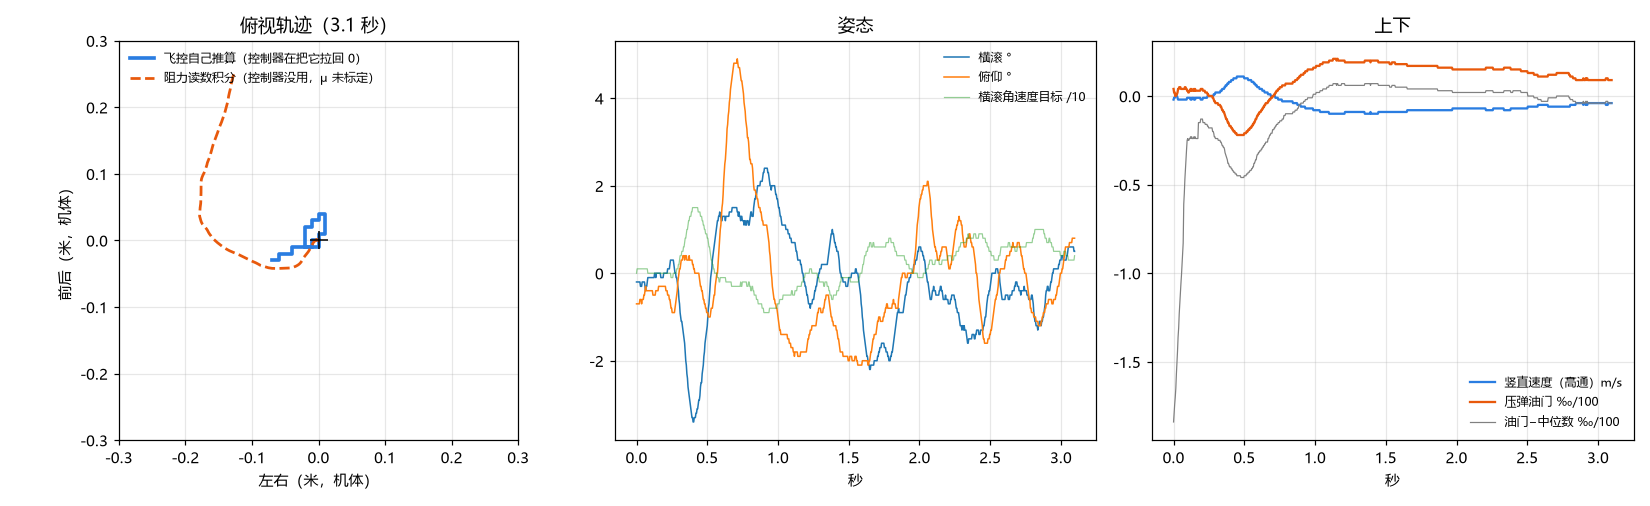
flights/latest_175441.png
