cdh66666/mini-drone/flights/video/20261111_132759_check.jpg

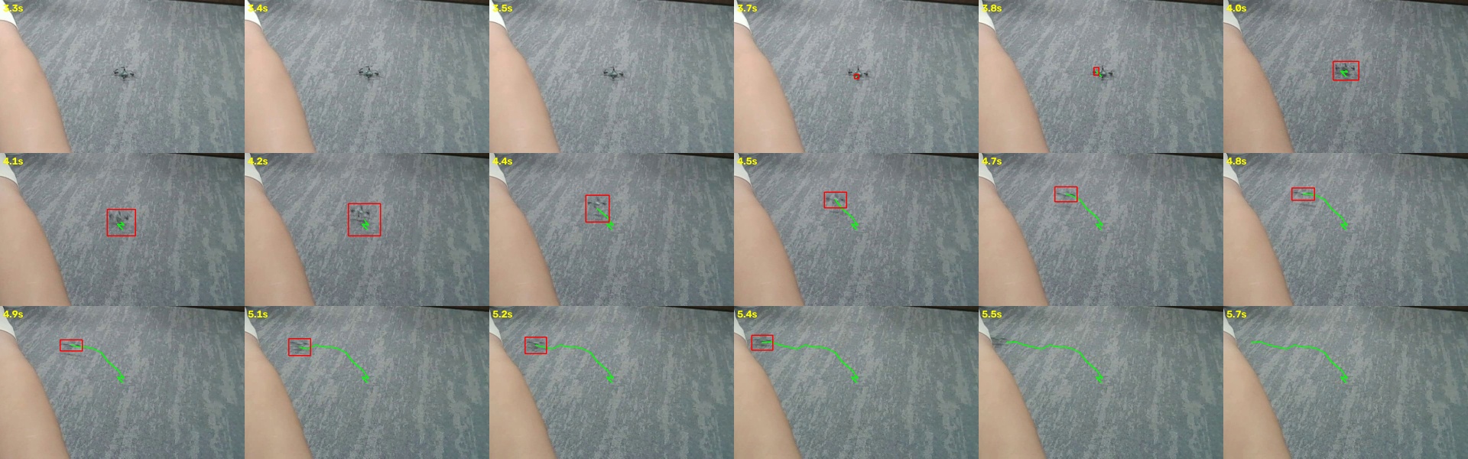
flights/video/20261111_132759_check.jpg
