cdh66666/mini-drone/flights/video/20261111_170733_check.jpg

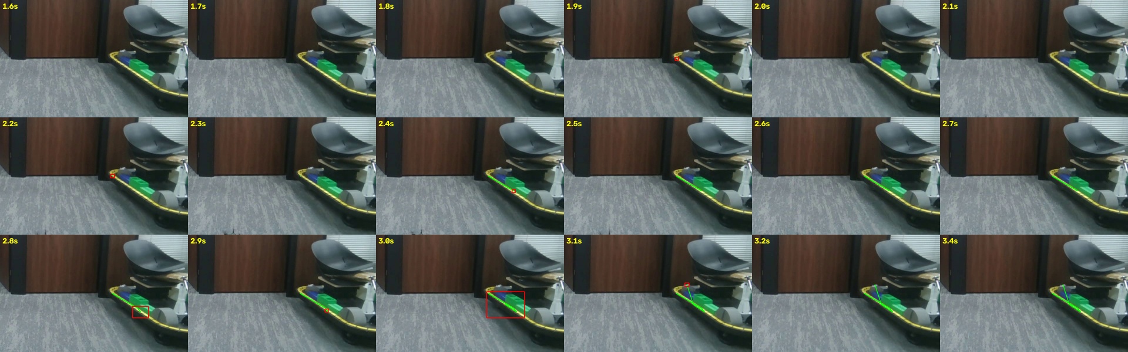
flights/video/20261111_170733_check.jpg
