cdh66666/mini-drone/flights/video/20261111_170946_check.jpg

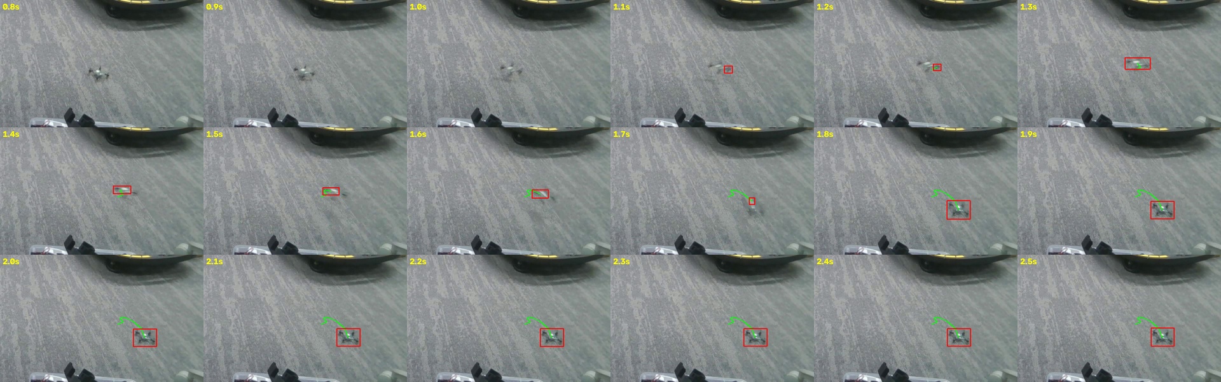
flights/video/20261111_170946_check.jpg
