cdh66666/mini-drone/docs/hardware/schematic.pdf

# ESP32 1S 四旋翼 v4 — 文档说明修订；制造 HOLD，禁止直接投板

01 USB-C 接口：Rd 仅表示设备接入 | 04 ESP32-S3 / ADC / 复位与下载

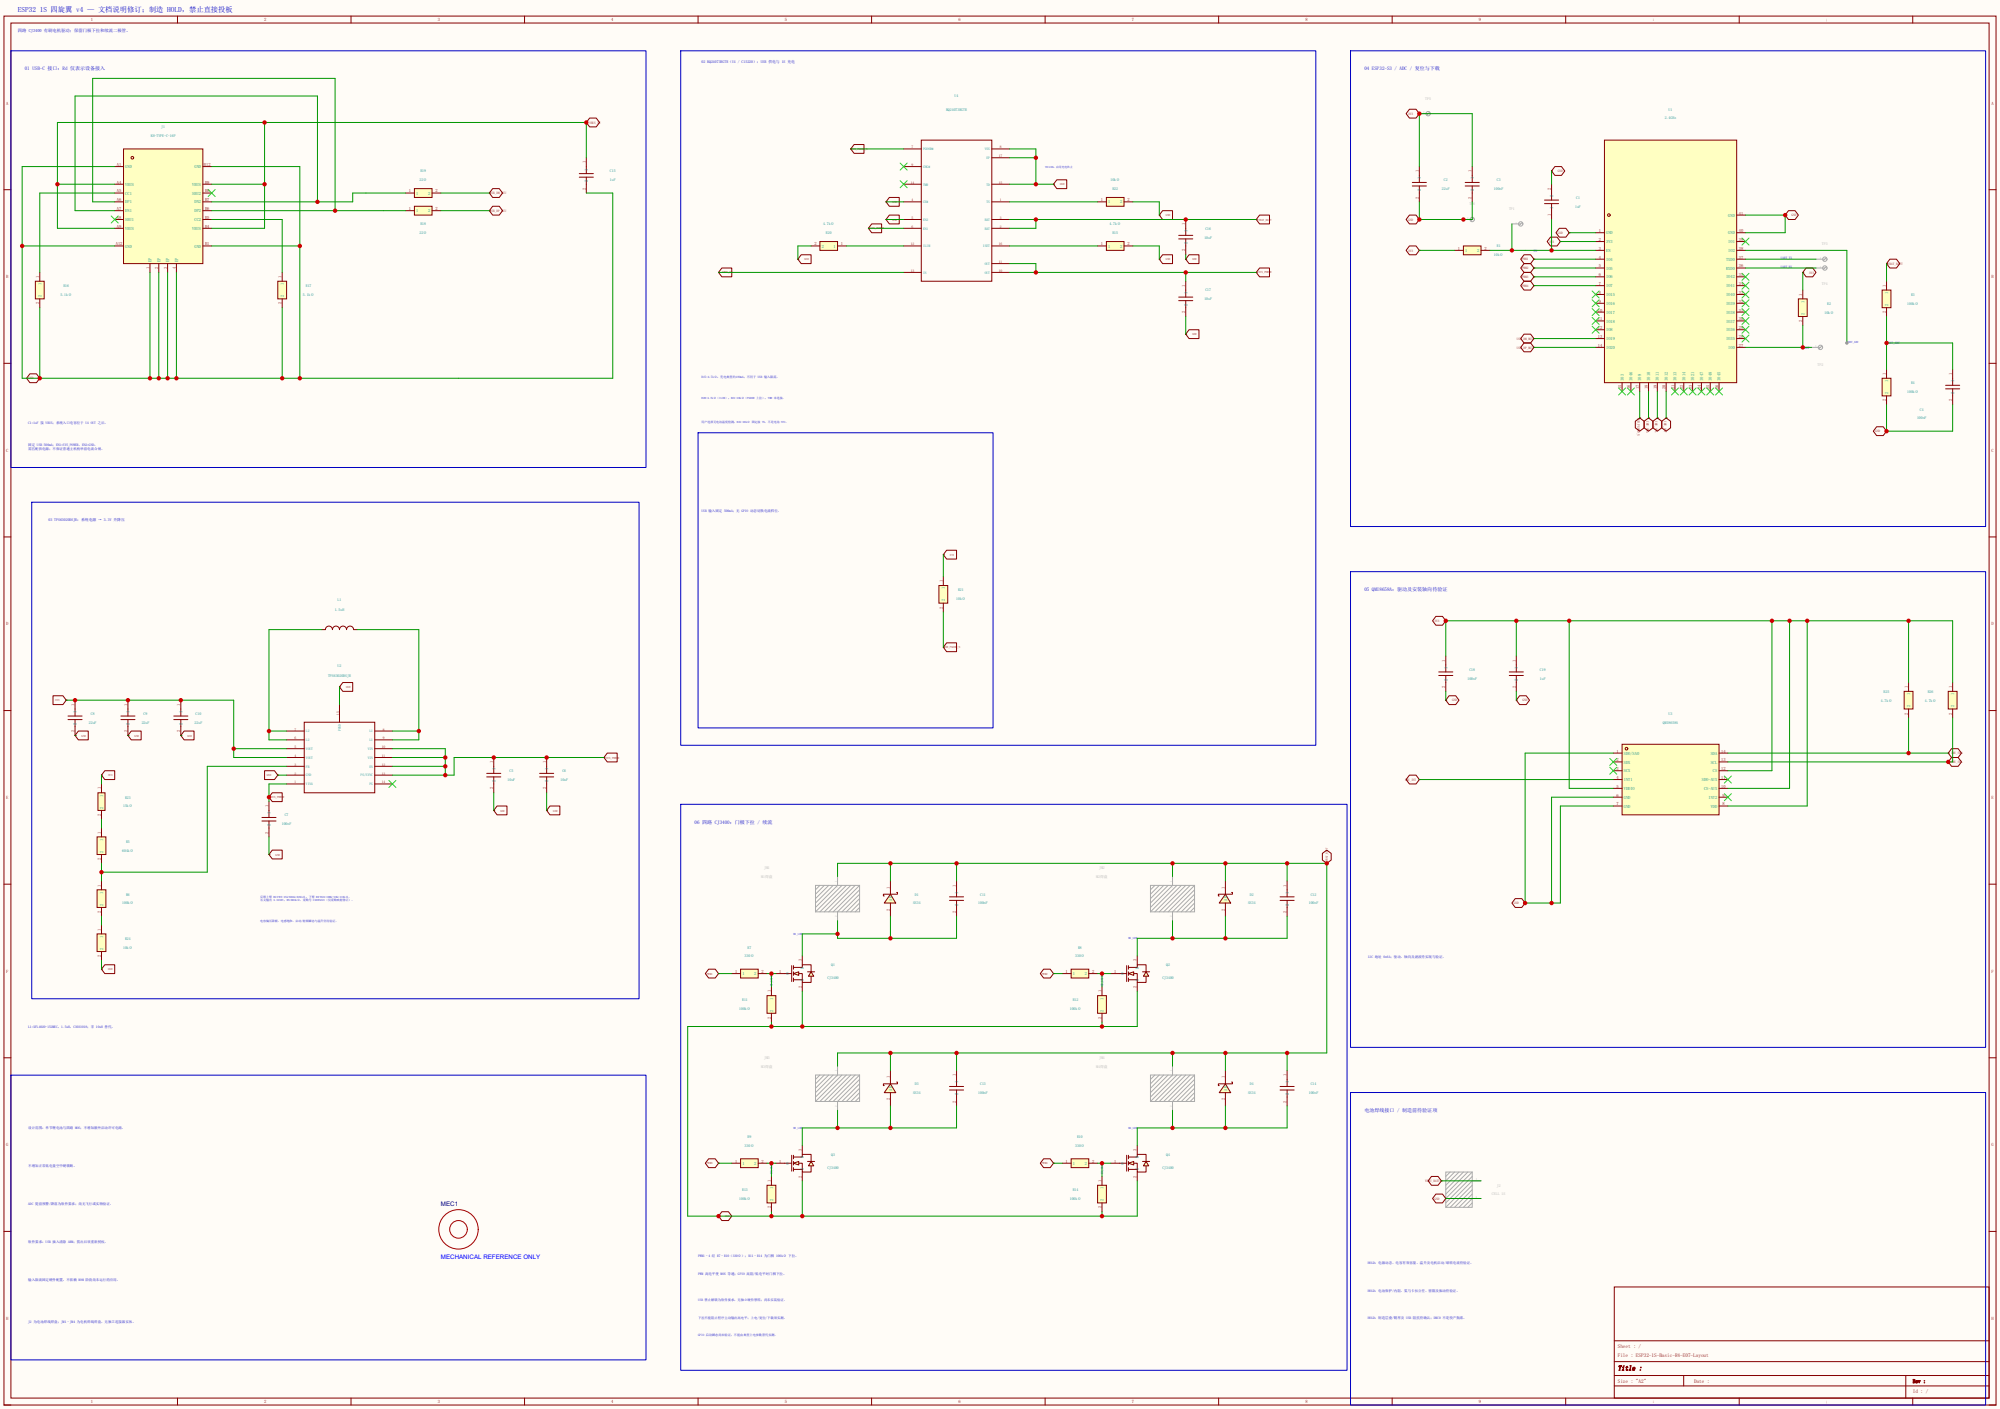
[picture p19: page 1]

R15=4.7kΩ：充电典型约189mA；不同于 USB 输入限流。
用户选择无电池温度检测；R22=10kΩ 固定接 TS，不是电池 NTC。 M1_GATE M3_GATE

R20=4.7kΩ（ILIM）；R21=10kΩ（PGOOD 上拉）；TMR 未连接。

C1=1uF 接 VBUS；系统入口电容位于 U4 OUT 之后。

USB 输入固定 500mA；无 GPIO 动态切换电流档位。

电容偏压降额、电感饱和、启动/射频瞬态与温升仍待验证。

设计范围：单节锂电池与四路 MOS；不增加额外启动许可电路。

ADC 提前预警/降落为软件要求；尚无飞行或实物验证。

软件要求：USB 插入清除 ARM；拔出后须重新授权。

HOLD：电源动态、电容有效容量、温升及电机启动/堵转电流待验证。

输入限流固定硬件配置，不依赖 ROM 阶段尚未运行的应用。

PWM 高电平使 MOS 导通；GPIO 高阻/低电平时门极下拉。

USB 禁止解锁为软件要求，无独立硬件禁转；尚未实装验证。

HOLD：电池保护/内阻、桨与卡扣公差、留隙及振动待验证。

下拉不能阻止程序主动输出高电平；上电/复位/下载须实测。

HOLD：制造层叠/铜厚及 USB 阻抗待确认；DRC0 不是投产批准。
