cdh66666/mini-drone/docs/hardware/pcb.pdf

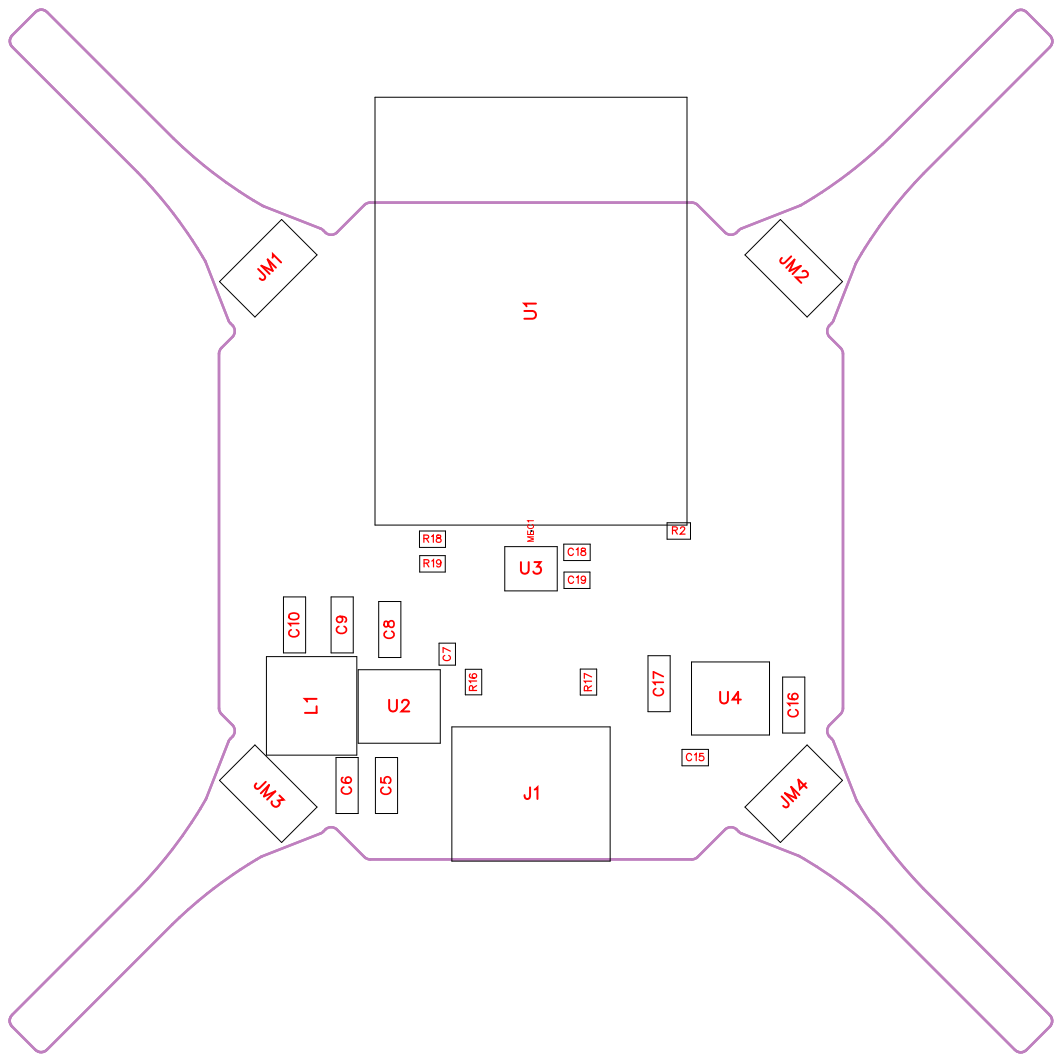
[picture p20: page 1]

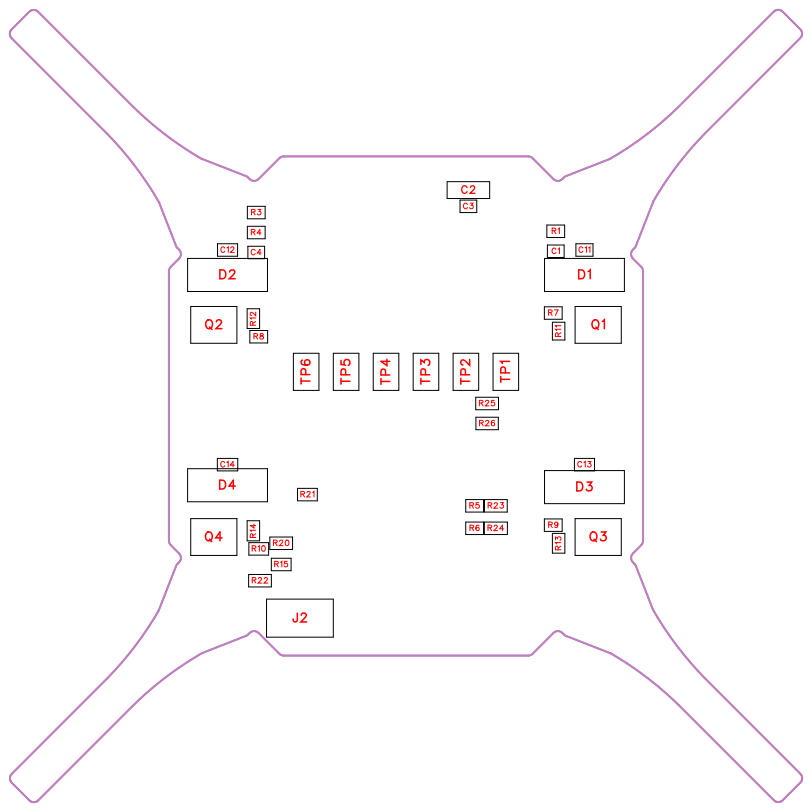
[picture p21: page 2]

No. | Quantity | Comment | Designator | Footprint | Value | Manufacture r Part | Manufacture r | Supplier Part | Supplier
1 | 3 | 1uF | C1,C15,C19 | C0402 | 1uF | FCC0402X105 K100AT | FOJAN(富捷) | C5137473 | LCSC
2 | 4 | 22uF | C2,C8,C9,C10 | C0805 | 22uF | FCC0805X226 M100FT | FOJAN(富捷) | C5137600 | LCSC
3 | 8 | 100nF | C3,C4,C7,C11,C12,C13,C14 ,C18 | C0402 | 100nF | FCC0402B104 K160AT | FOJAN(富捷) | C5137468 | LCSC
4 | 4 | 10uF | C5,C6,C16,C17 | C0805 | 10uF | FCC0805X106 K100FT | FOJAN(富捷) | C5137471 | LCSC
5 | 4 | SS34 | D1,D2,D3,D4 | SMA_L4.3-W2 .6-LS5.2-RD | SS34 | SS34 | MDD(辰达半 导体) | C8678 | LCSC
6 | 1 | KH-TYPE-C-1 6P | J1 | USB-C-SMD_K H-TYPE-C-16 P | KH-TYPE-C-1 6P | KH-TYPE-C-1 6P | kinghelm(金 航标) | C709357 | LCSC
7 | 1 | 1.5uH | L1 | IND-SMD_L5. 4-W5.2 | 1.5uH | MWSA0518S-1 R5MT | Sunlord(顺 络) | C408344 | LCSC
8 | 4 | CJ3400 | Q1,Q2,Q3,Q4 | SOT-23_L2.9 -W1.3-P1.90 -LS2.4-BR | CJ3400 | CJ3400 | CJ(江苏长电 /长晶) | C19019 | LCSC
9 | 5 | 10kΩ | R1,R2,R21,R22,R24 | R0402 | 10kΩ | FRC0402F100 2TS | FOJAN(富捷) | C2906861 | LCSC
10 | 7 | 100kΩ | R3,R4,R6,R11,R12,R13,R14 | R0402 | 100kΩ | FRC0402F100 3TS | FOJAN(富捷) | C2906859 | LCSC
11 | 1 | 604kΩ | R5 | R0402 | 604kΩ | CRCW0402604 KFKED | VISHAY(威世 ) | C2085221 | LCSC
12 | 4 | 330Ω | R7,R8,R9,R10 | R0402 | 330Ω | FRC0402F330 0TS | FOJAN(富捷) | C2930002 | LCSC
13 | 4 | 4.7kΩ | R15,R20,R25,R26 | R0402 | 4.7kΩ | FRC0402F470 1TS | FOJAN(富捷) | C2906869 | LCSC
14 | 2 | 5.1kΩ | R16,R17 | R0402 | 5.1kΩ | FRC0402F510 1TS | FOJAN(富捷) | C2906874 | LCSC
15 | 2 | 22Ω | R18,R19 | R0402 | 22Ω | FRC0402F22R 0TS | FOJAN(富捷) | C2929994 | LCSC
16 | 1 | 15kΩ | R23 | R0402 | 15kΩ | RC-02K1502F T | FH(风华) | C453552 | LCSC
17 | 1 | 2.4GHz | U1 | WIRELM-SMD_ ESP32-S3-WR OOM-1 | 2.4GHz | ESP32-S3-WR OOM-1-N8R2 | ESPRESSIF( 乐鑫) | C2913204 | LCSC
18 | 1 | TPS63020DSJ R | U2 | VSON-14_L4. 0-W3.0-P0.5 0-BL-EP_TI_ DSJ | TPS63020DSJ R | TPS63020DSJ R | TI(德州仪器 ) | C15483 | LCSC
19 | 1 | QMI8658A | U3 | LGA-14_L3.0 -W2.5-P0.50 -TL | QMI8658A | QMI8658A | QST(上海矽 睿) | C3021082 | LCSC
20 | 1 | BQ24073RGTR | U4 | QFN-16_L3.0 -W3.0-P0.50 -TL-EP1.7 | BQ24073RGTR | BQ24073RGTR | TI(德州仪器 ) | C15220 | LCSC

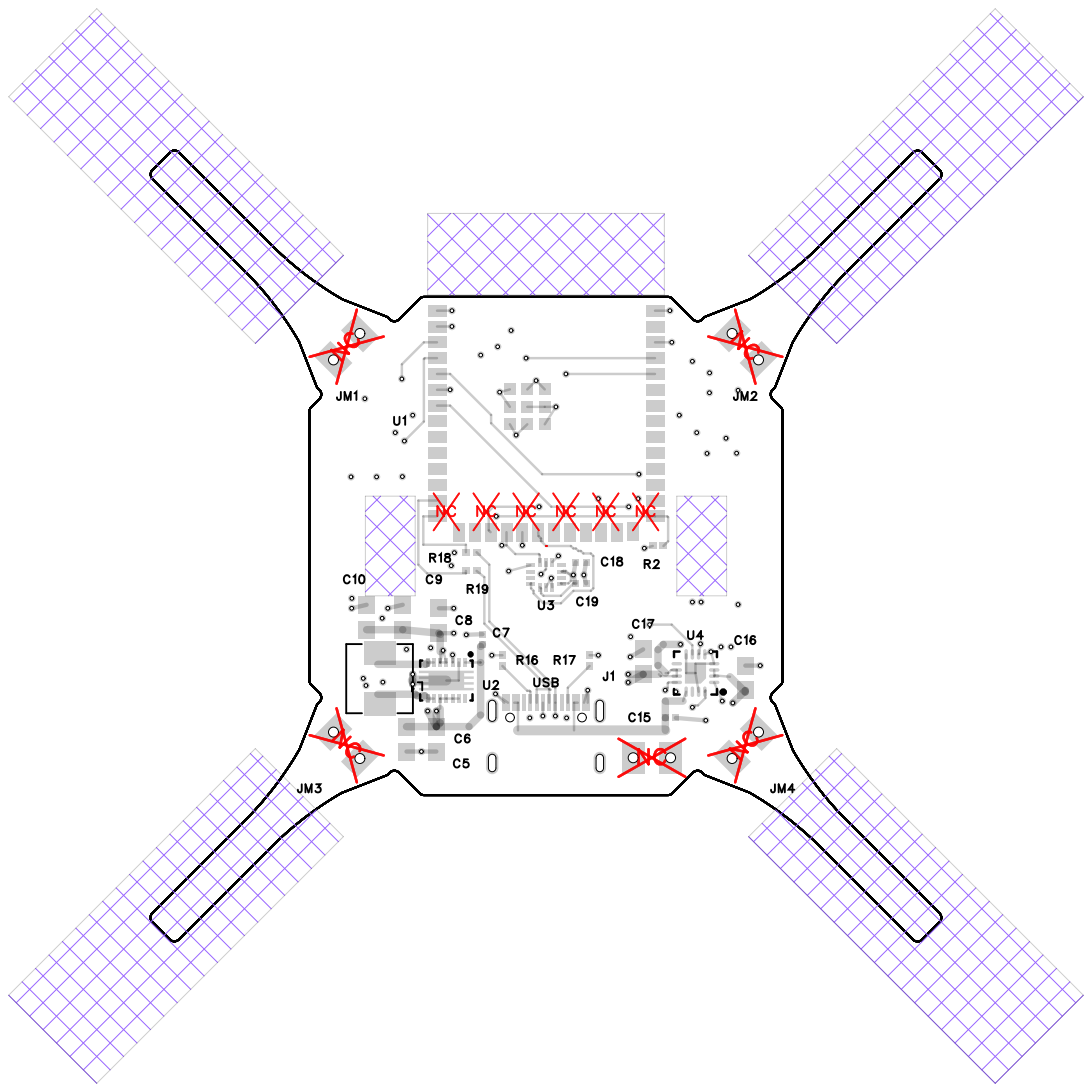
[picture p22: page 4]

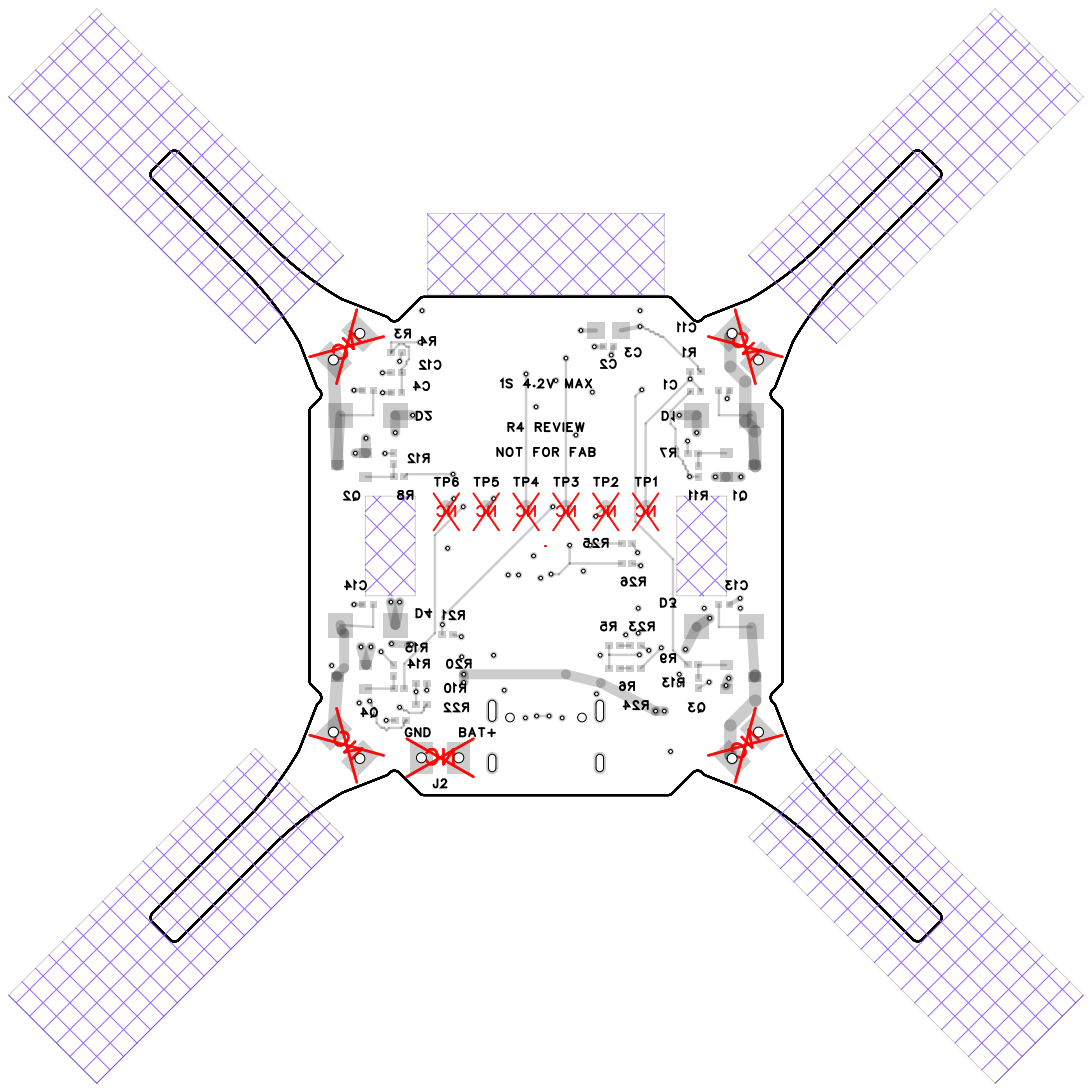
[picture p23: page 5]

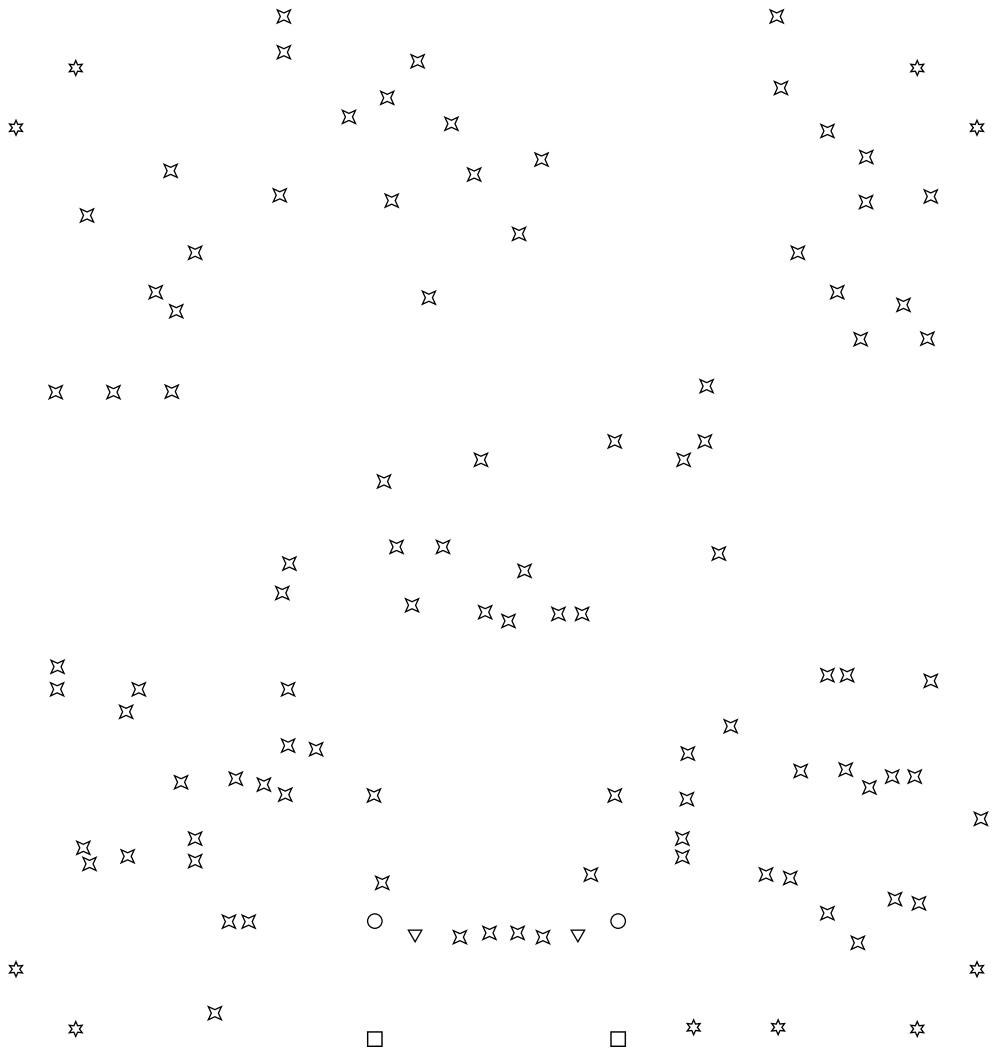
[picture p24: page 6]
