cdh66666/mini-drone/(commit log)

2026-11-11 mini-drone: firmware v11, debug console, flight logs
    [20261109_231945.csv, 20261109_231951.csv, 20261109_231956.csv, 20261109_232005.csv, 20261109_232028.csv, 20261109_232100.csv, 20261110_020752.csv, 20261110_021240.csv]
2026-11-11 加回硬件资料包（电路板/原理图/物料）和整片固件备份
2026-11-11 README 展示：3D 渲染、原理图、PCB、调试台截图、飞行录像分析
2026-11-11 调试台飞行页加摄像头实时画面；v11 试飞记录
    - 服务端 /api/cam.mjpg 实时视频流，飞行页显示画面和“录像中”标记
    - 11-11 17:07~17:09 四次 v11 飞行的黑匣子、整次记录、录像追踪结果
    [20261111_170733.csv, 20261111_170733_t.csv, 20261111_170733_track.csv, 20261111_170735.csv, 20261111_170744.csv, 20261111_170744_t.csv, 20261111_170744_track.csv, 20261111_170746.csv]
2026-11-11 固件 v12：阻力测速（先记录，修正默认关）+ 拟合脚本
    - 空中加计倾角≈空气阻力，可直接感到慢漂，和水平校准偏差无关
    - 黑匣子加 ap/ar/vdx/vdy；E,mu / E,dk 可调，dk 默认 0
    - tools/fit_drag.py：只用飞机自己的数据拟合阻力系数
    [20261111_171328.csv, 20261111_171344.csv, 20261111_171344_t.csv, 20261111_171346.csv]
2026-11-11 摄像头默认关闭：不开、不录像、不占内存
    要开时在 camera.txt 写摄像头编号；关着时页面不显示画面，/api/cam.mjpg 返回 404。
2026-11-11 固件 v13：平稳起飞 + 定高（只用飞机自己的加速度计）
    - 起飞后平滑爬升到 0.4 m 再定住，避开贴地上下弹
    - 油门按学到的悬停油门 + 高度/速度/积分控制，不依赖一键油门值
    - 落地后自动修正悬停油门并保存；动油门（降落）立即交回手动
    - 黑匣子加 vz/hz/htg
    [flight_v13.ino]
2026-11-11 固件 v14：起飞软启动 + 压上下弹；v13 定高默认关
    - v13 实飞：振动让竖直加计偏差随油门变，高度估计几秒就漂几十厘米，起飞冲击变大 → 关
    - v14：起飞油门 0.3 s 软启动；竖直速度高通后反向加减油门，只压贴地上下弹
    - 新参数 kdz/tz/dzmax/tramp，可在线改
    [20261111_174455.csv, 20261111_174457.csv, 20261111_174516.csv, 20261111_174518.csv, 20261111_174527.csv, 20261111_174528.csv]
2026-11-11 回放和飞行页标清楚：自估轨迹不是真实位置；回放加阻力读数轨迹
    - 绿线 = 飞机自估（v11 起控制器在把它拉回原点，天然好看）
    - 橙虚线 = 阻力读数积分（v12+，控制器没用，距离待标定）
    [20261111_175440.csv, 20261111_175441.csv]
2026-11-11 交接：匀速慢漂只靠 IMU 看不出来（物理限制），更正之前阻力测速的说法
2026-11-11 固件 v15 机头锁定；配平 0.2°、方向键 6°、一键起飞 64%、W/S 1%
    - 数据显示每次飞行机头转 25~55°，方向键按机头算所以方向乱 → 空中锁定起飞时的机头
    - 方向键 3.5° 推不动 → 6°；配平每点 0.2°
    - 60% 浮在地效里只有 5~10 cm → 默认 64%
    [20261111_181755.csv, 20261111_181756.csv, 20261111_181806.csv, 20261111_181808.csv, 20261111_181813.csv, 20261111_181814.csv, 20261111_181821.csv, 20261111_181824.csv]
2026-11-11 机头锁定加强到 3（连上自动写入）；记录 v15 试飞分析
    - tune.json 加 ya=3，页面连接时随其他参数一起写入
    - 18:42 五次飞行：机头锁定有效（±15°），电池已到低压保护边缘
    [20261111_184155.csv, 20261111_184157.csv, 20261111_184205.csv, 20261111_184207.csv, 20261111_184210.csv, 20261111_184211.csv, 20261111_184218.csv, 20261111_184220.csv]
2026-11-11 配平每点 0.1°
    [20261111_184931.csv, 20261111_184933.csv, 20261111_190914.csv, 20261111_190916.csv, 20261111_190925.csv, 20261111_190926.csv, 20261111_190937.csv, 20261111_190939.csv]
2026-11-11 电量显示修正：飞完等电压回升、插电不掉、实测充电偏移；后台记电池电压
    [20261111_191532.csv, 20261111_191533.csv, 20261111_191539.csv, 20261111_191541.csv, 20261111_191547.csv, 20261111_191549.csv, 20261111_191552.csv, 20261111_191553.csv]
2026-11-11 电量：飞完只等 10 秒就更新
    [battery_log.csv]
2026-11-11 电量：飞完马上更新，平滑缩到 5 秒
    [battery_log.csv]
